eutectic6337/SAO-display/PCB/SAO-display/SAO-display.kicad_sch

## KiCad design PCB/SAO-display/SAO-display.kicad_sch (2025-08-08)

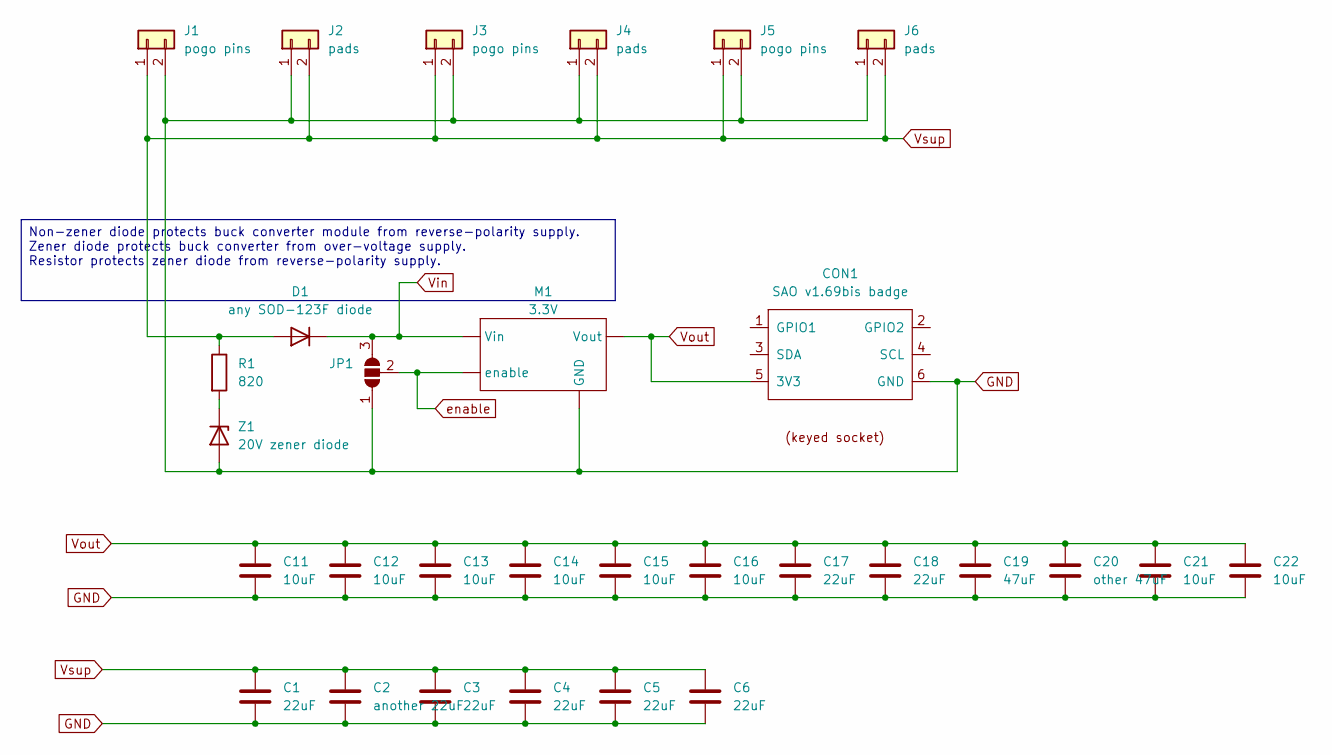
[picture p1: schematic SAO-display.kicad_sch]

Parts:
C1, C3, C4, C5, C6: 22uF; C_0805_2012Metric_Pad1.18x1.45mm_HandSolder; LCSC Part # C602037
C2: another 22uF; C_1206_3216Metric; LCSC Part # C7432786
C11, C12, C13, C14, C15, C16, C21, C22: 10uF; C_0402_1005Metric_Pad0.74x0.62mm_HandSolder; LCSC Part # C15525
C17: 22uF; C_0603_1608Metric; LCSC Part # C59461
C18: 22uF; C_0805_2012Metric; LCSC Part # C5674
C19: 47uF; C_1206_3216Metric; LCSC Part # C22399657
C20: other 47uF; C_1206_3216Metric; LCSC Part # C68361
CON1: SAO v1.69bis badge; IDC-Header_2x03_P2.54mm_Vertical
D1: any SOD-123F diode; D_SOD-123F; LCSC Part # C42441798
J1, J3, J5: pogo pins; PinHeader_1x02_P2.54mm_Vertical
J2, J4, J6: pads; PinHeader_1x02_P2.54mm_Vertical
JP1: SolderJumper_3_Open; SolderJumper-3_P1.3mm_Open_Pad1.0x1.5mm_NumberLabels
M1: 3.3V
R1: 820; R_0603_1608Metric_Pad0.98x0.95mm_HandSolder
Z1: 20V zener diode; D_SOD-123; LCSC Part # C7544551

Connections:
GND: C1.2, C2.2, C3.2, C4.2, C5.2, C6.2, C11.2, C12.2, C13.2, C14.2, C15.2, C16.2, C17.2, C18.2, C19.2, C20.2, C21.2, C22.2, CON1.6 (GND), J1.2, J2.1, J3.2, J4.1, J5.2, J6.1, JP1.1 (A), M1., Z1.2 (A)
unnamed: R1.2, Z1.1 (K)
Vin: D1.1 (K), JP1.3 (B), M1.
Vout: C11.1, C12.1, C13.1, C14.1, C15.1, C16.1, C17.1, C18.1, C19.1, C20.1, C21.1, C22.1, CON1.5 (3V3), M1.
Vsup: C1.1, C2.1, C3.1, C4.1, C5.1, C6.1, D1.2 (A), J1.1, J2.2, J3.1, J4.2, J5.1, J6.2, R1.1
enable: JP1.2 (C), M1.

Notes on the sheet:
Non-zener diode protects buck converter module from reverse-polarity supply. Zener diode protects buck converter from over-voltage supply. Resistor protects zener diode from reverse-polarity supply.
