eutectic6337/SAO-display/(commit log)

2025-03-16 made a PCB
    [SAO-display.kicad_pcb, SAO-display.kicad_sch]
2025-03-16 drawings of magnetic pogo-pin connectors
2025-03-16 add repo QR code and silk
    [SAO-display.kicad_pcb]
2025-03-17 add decoupling capacitors
    [SAO-display.kicad_pcb, SAO-display.kicad_sch]
2025-03-17 add zener to protect input caps
    [SAO-display.kicad_pcb, SAO-display.kicad_sch]
2025-03-17 add LCSC part numbers
    [SAO-display.kicad_pcb, SAO-display.kicad_sch]
2025-03-18 add extra (larger) footprints for alternative capacitors
    [SAO-display.kicad_pcb, SAO-display.kicad_sch]
2025-03-18 add another alternative capacitor
    [SAO-display.kicad_pcb, SAO-display.kicad_sch]
2025-03-29 removed selectable-output converter; tweaked footprints
    [SAO-display.kicad_pcb]
2025-04-06 flip connections to half the pogo pins; add protection diode
    [SAO-display.kicad_pcb, SAO-display.kicad_sch]
2025-04-09 remove some unnecessary vias
    [SAO-display.kicad_pcb]
2025-04-25 increase pogo-pin hole size a bit
    [SAO-display.kicad_pcb]
2025-04-25 regenerate fab files
    [SAO-display.kicad_pcb]
2025-05-30 add art to remind user of pin alignment requirement
    [SAO-display.kicad_pcb]
2025-06-17 add new front art
    [SAO-display.kicad_pcb]
2025-06-17 generated production files
    [SAO-display.kicad_pcb]
2025-06-17 minimized silkscreen footprint of SAO connector
    [SAO-display.kicad_pcb]
2025-08-08 add current-limiting resistor to Zener
    [SAO-display.kicad_pcb, SAO-display.kicad_sch]
